sscp/ws22-refresh/extras/ws22-logic-pcba-release-fixture.3mf

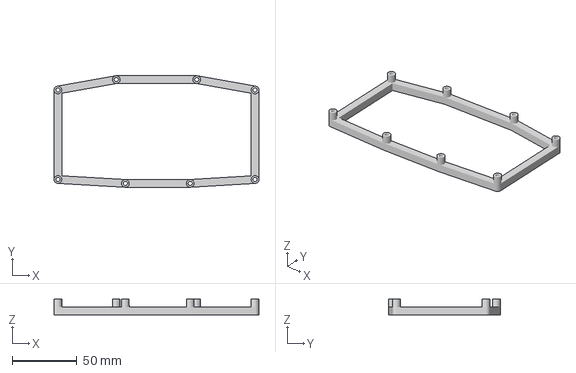
[picture p1: CAD file, 2025-01-11]
extras/ws22-logic-pcba-release-fixture.3mf
158.0 x 86.0 x 12.0 mm
