sscp/ws22-refresh/(list of files, cad)

Other CAD files:
extras/ws22-logic-pcba-release-fixture.f3d
extras/ws22-stock-enclosure.f3d
