sscp/ws22-refresh/pcba/ws22_companion-1_0_0/ws22_companion-1_0_0.pdf

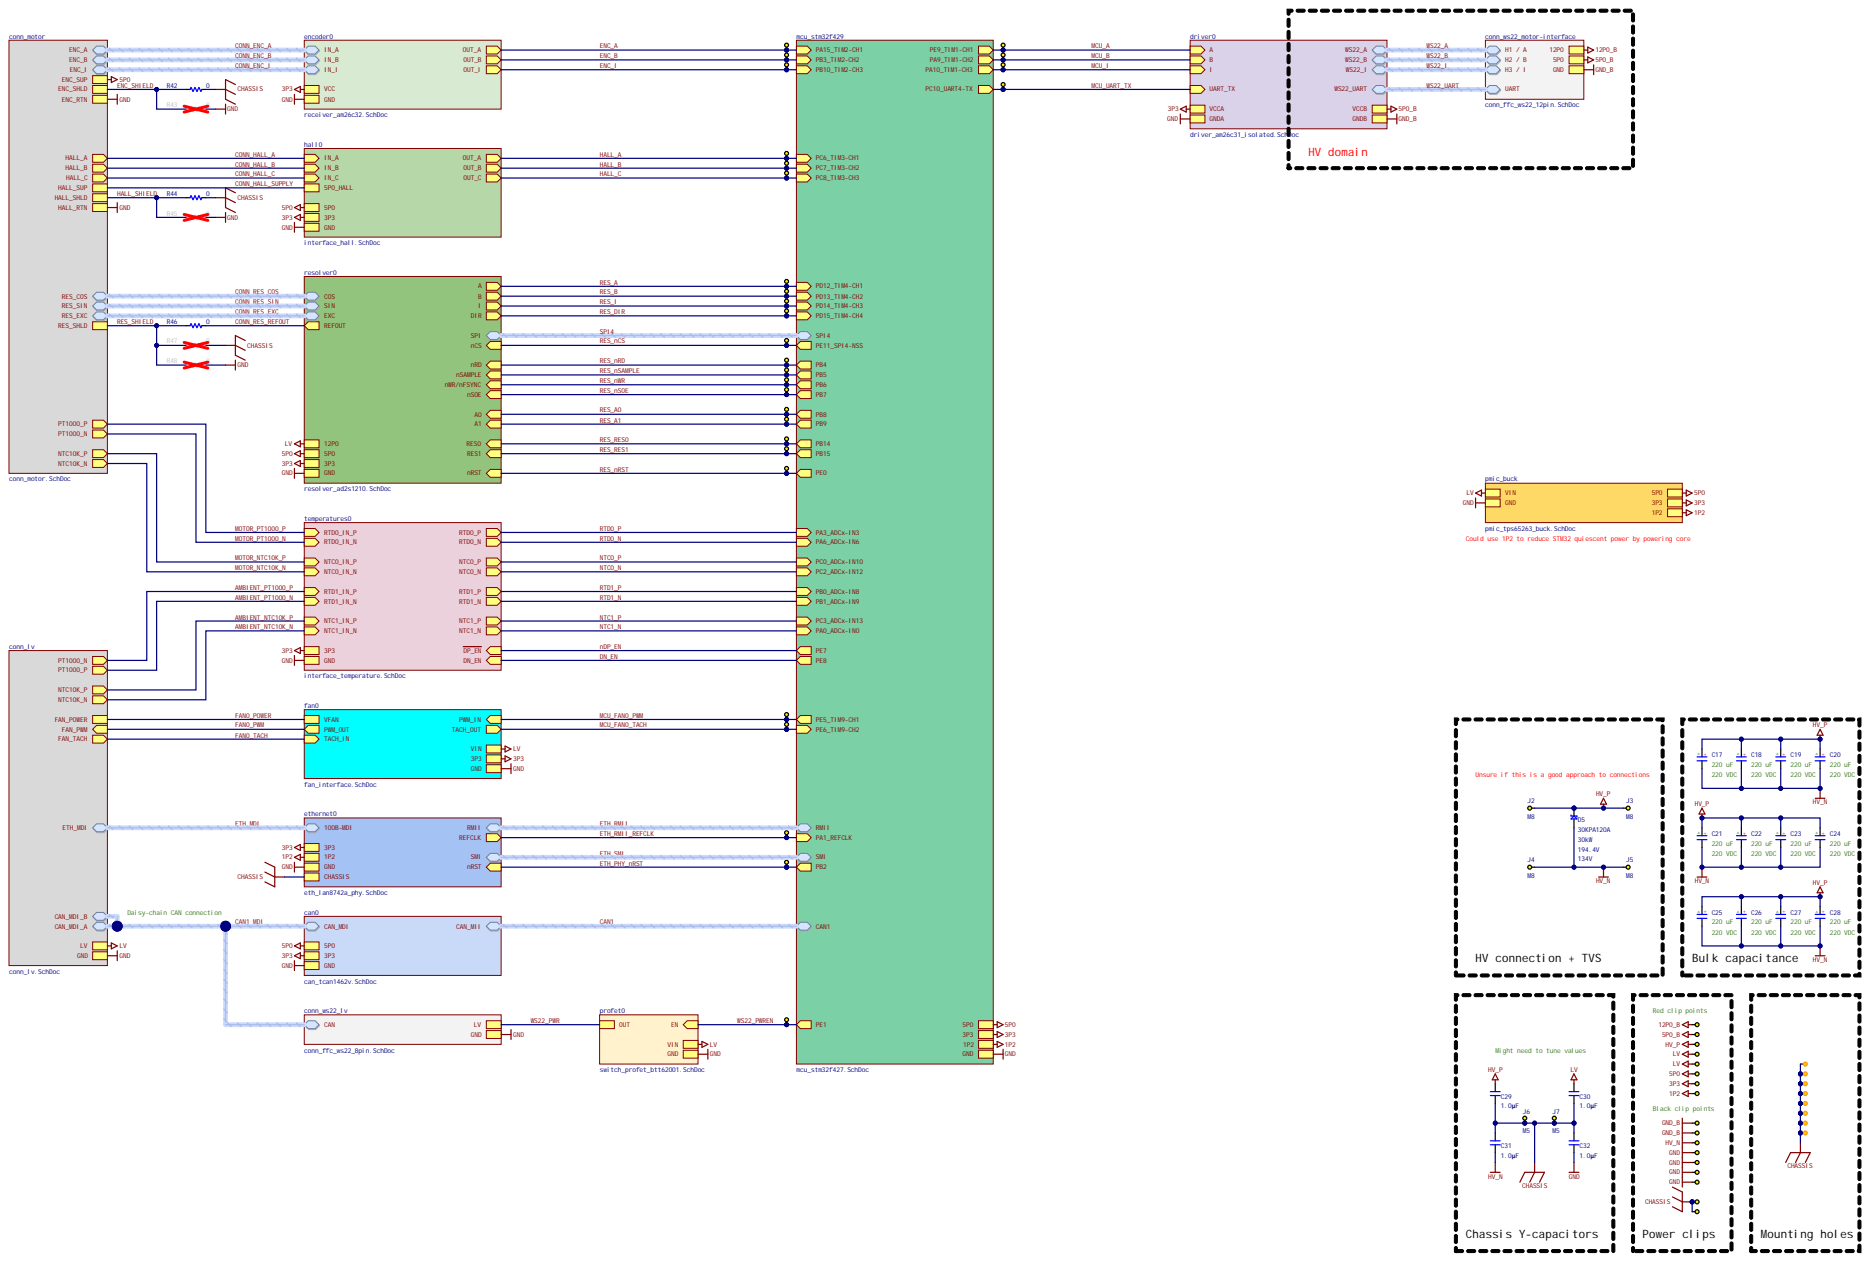
[picture p2: page 1]

CONN_ENC_B | | ENC_B | MCU_B | WS22_B
CONN_ENC_I | | ENC_I | MCU_I | WS22_I

MCU_UART_TX | WS22_UART

CONN_HALL_B | HALL_B
CONN_HALL_C | HALL_C

HALL_SHIELD R44

CONN_RES_SIN | | RES_I
CONN_RES_EXC | | RES_DIR

RES_SHIELD R46 0 CONN_RES_REFOUT | | SPI4

MOTOR_PT1000_N | RTD0_N

Could use 1P2 to reduce STM32 quiescent power by powering core

MOTOR_NTC10K_P | NTC0_P
MOTOR_NTC10K_N | NTC0_N

AMBIENT_PT1000_N | RTD1_N

AMBIENT_NTC10K_P | NTC1_P
AMBIENT_NTC10K_N | NTC1_N

PT1000_N PT1000_P NTC10K_P NTC10K_N FAN_POWER FAN_PWM FAN_TACH ETH_MDI CAN_MDI_B CAN_MDI_A LV GND | | DN_EN

3P3 | nDP_EN

Unsure if this is a good approach to connections

Daisy-chain CAN connection

Might need to tune values

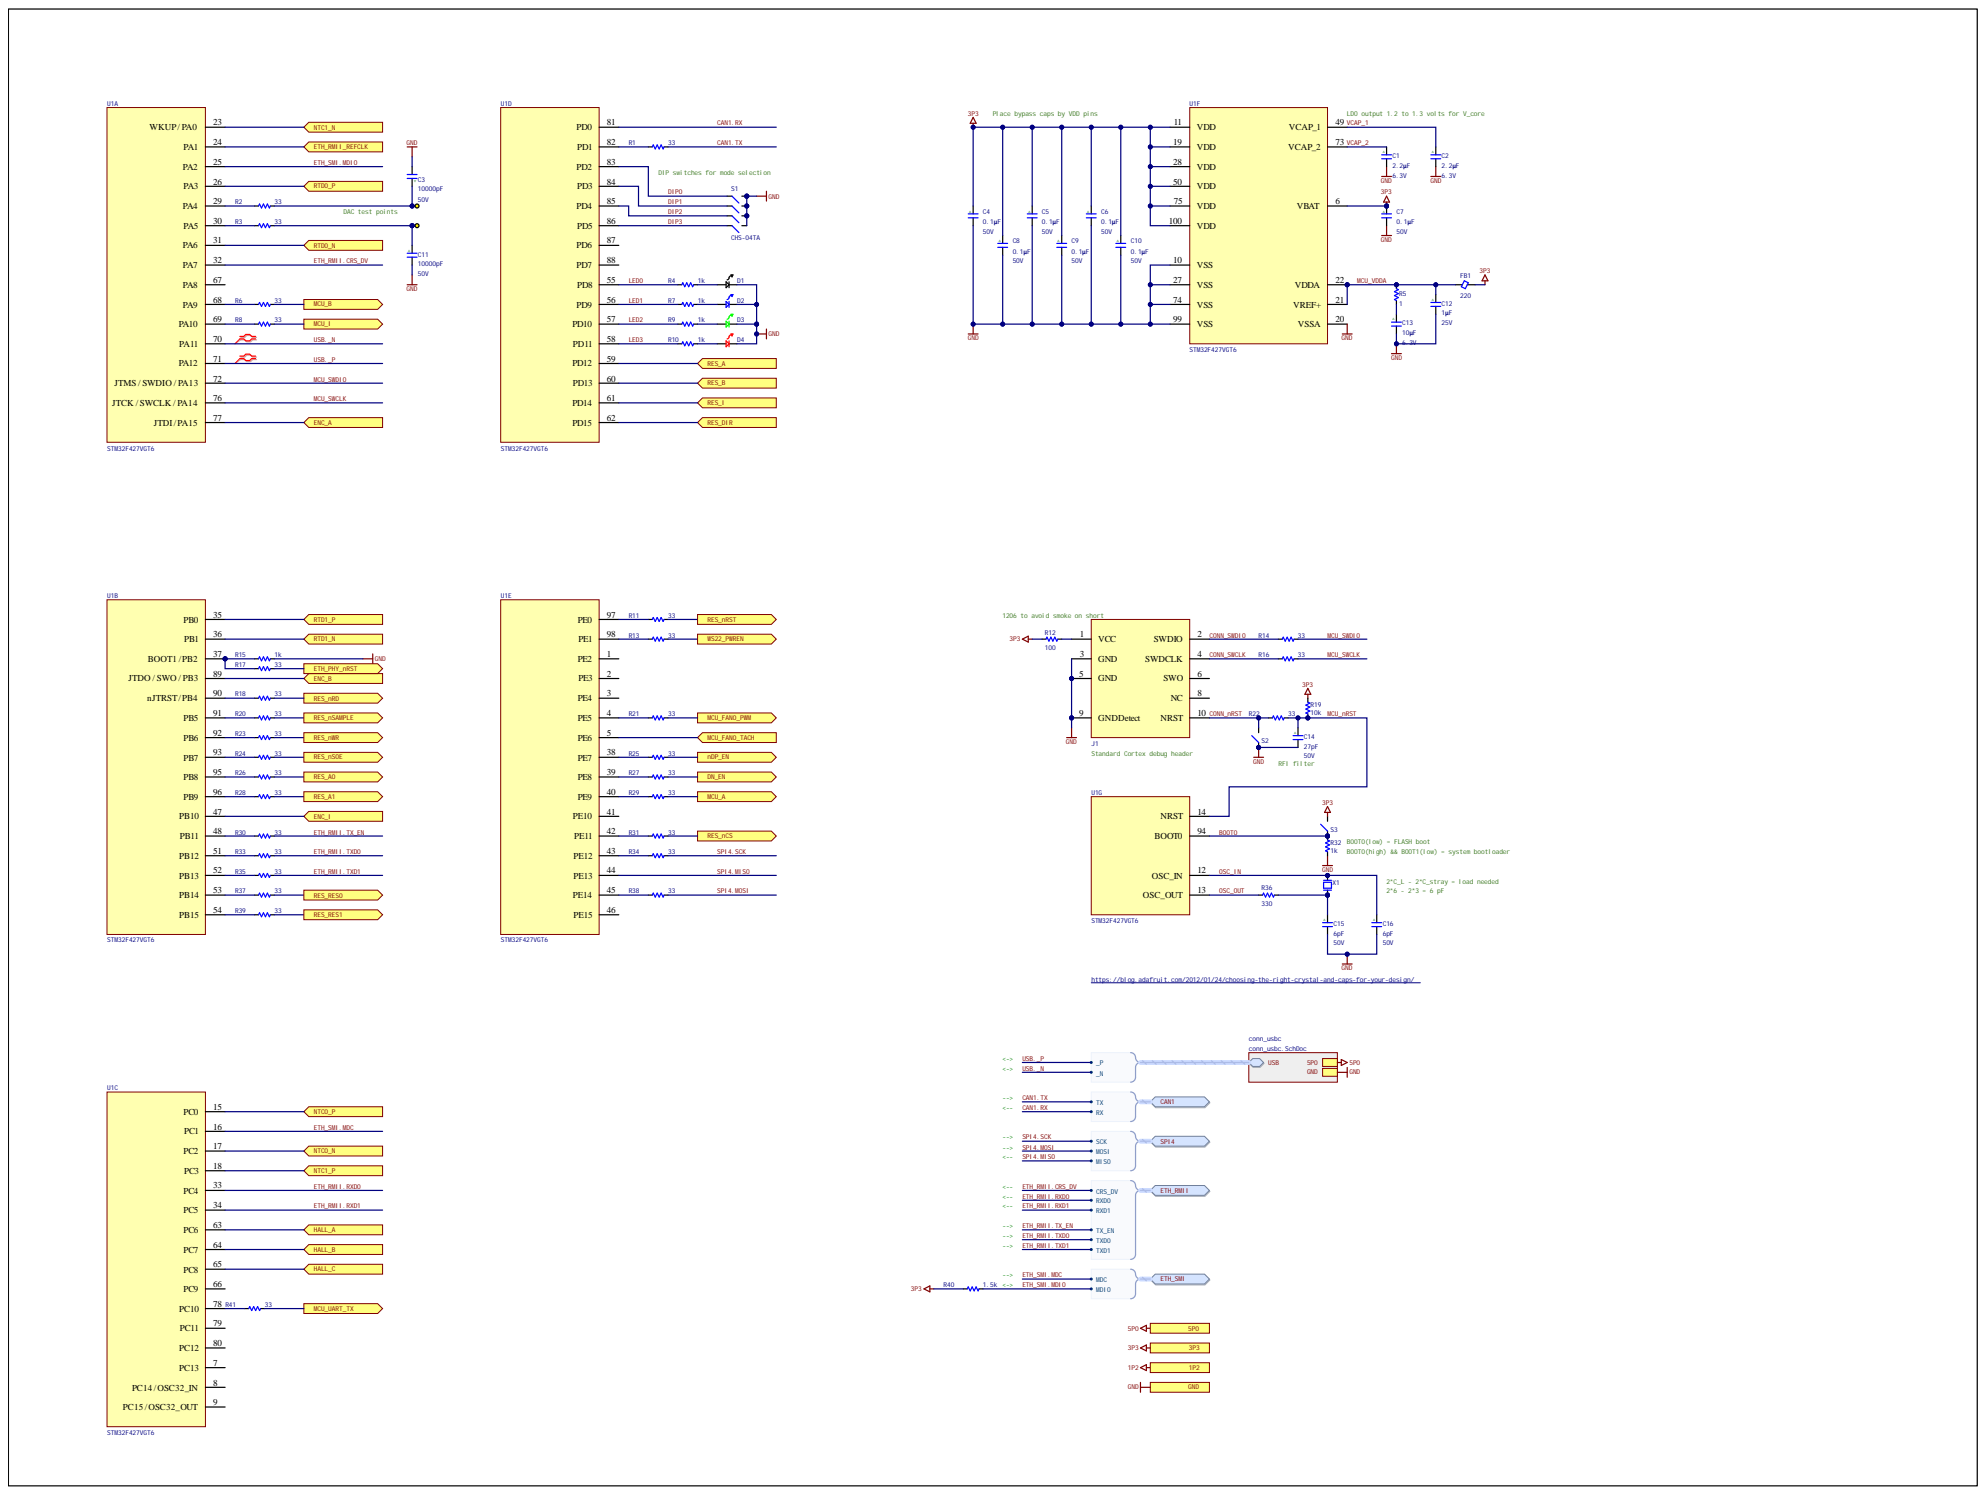
[picture p3: page 2]

Place bypass caps by VDD pins

LDO output 1.2 to 1.3 volts for V_core
VCAP_1

DIP switches for mode selection

1206 to avoid smoke on short

Standard Cortex debug header

https://blog.adafruit.com/2012/01/24/choosing-the-right-crystal-and-caps-for-your-design/

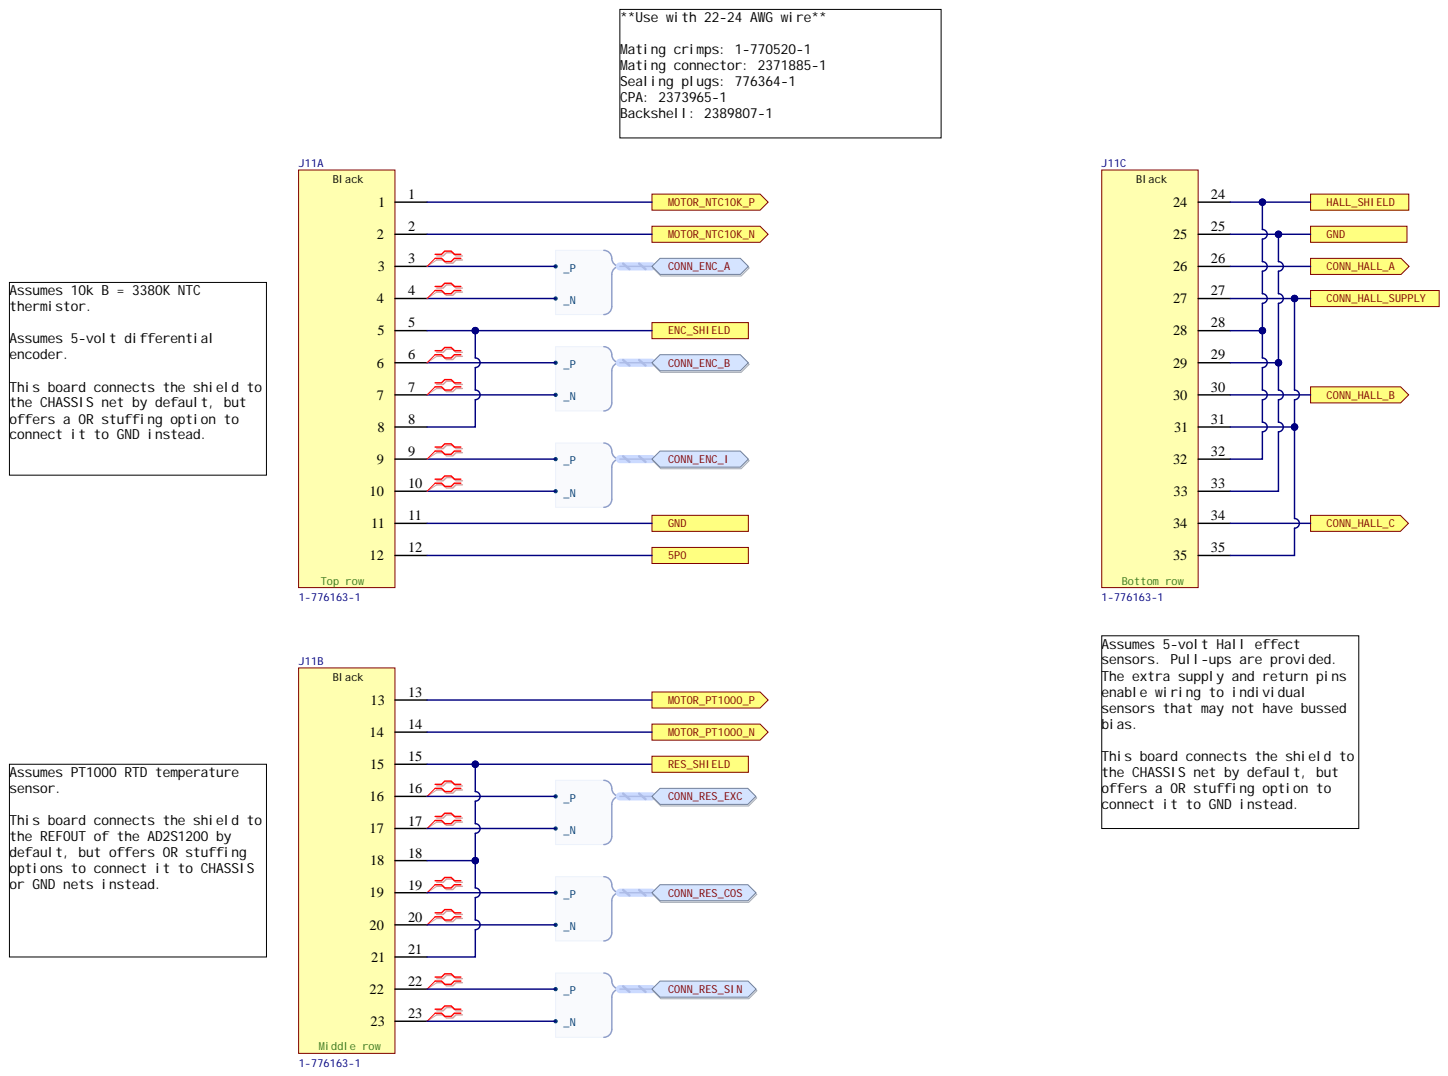
[picture p4: page 3]

**Use with 22-24 AWG wire**

This board connects the shield to
the CHASSIS net by default, but
offers a 0R stuffing option to
connect it to GND instead.

Assumes 5-volt Hall effect
sensors. Pull-ups are provided.
The extra supply and return pins
enable wiring to individual
sensors that may not have bussed
bias.

the REFOUT of the AD2S1200 by
default, but offers 0R stuffing
options to connect it to CHASSIS
or GND nets instead.

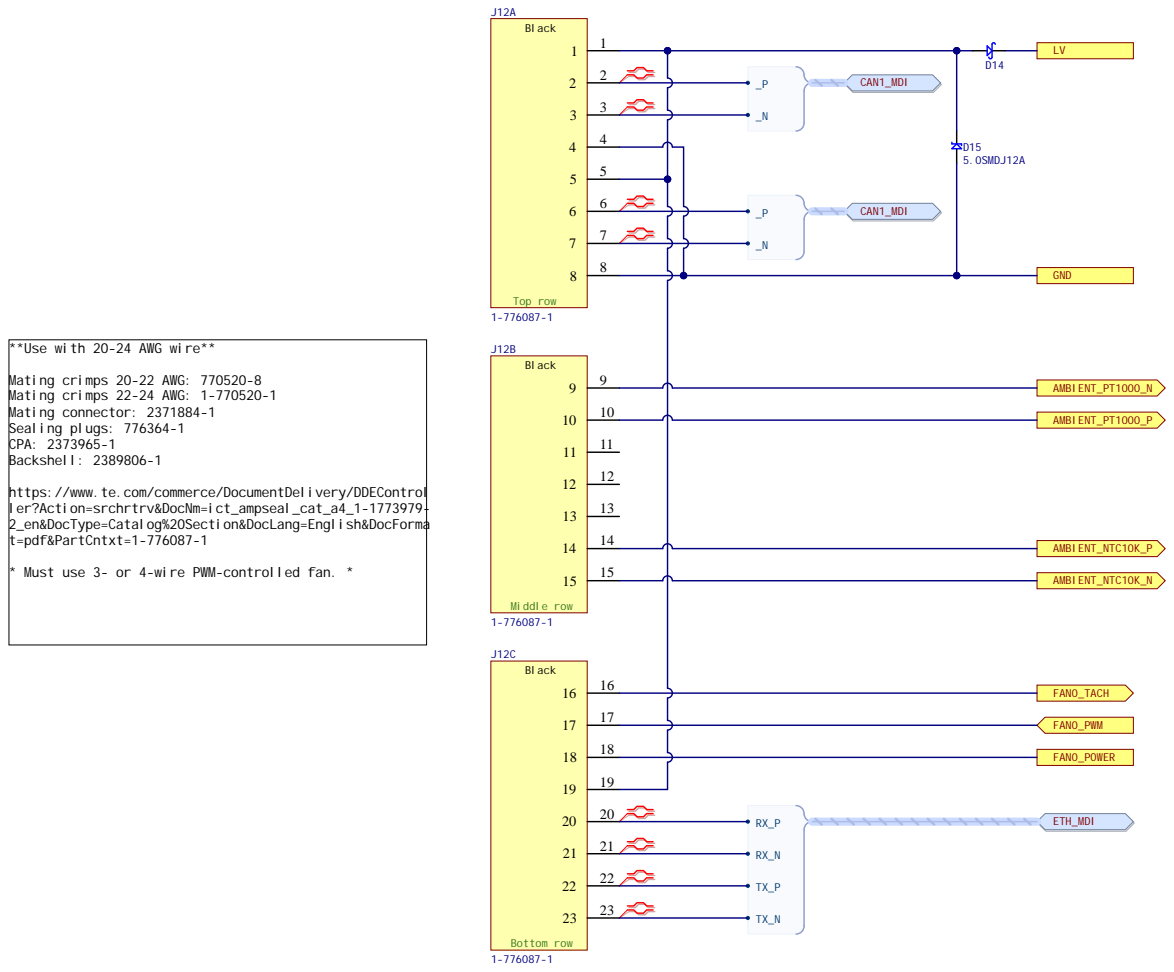
[picture p5: page 4]

**Use with 20-24 AWG wire**

https://www.te.com/commerce/DocumentDelivery/DDEControl
ler?Action=srchrtrv&DocNm=ict_ampseal_cat_a4_1-1773979-
2_en&DocType=Catalog%20Section&DocLang=English&DocForma
t=pdf&PartCntxt=1-776087-1

* Must use 3- or 4-wire PWM-controlled fan. *

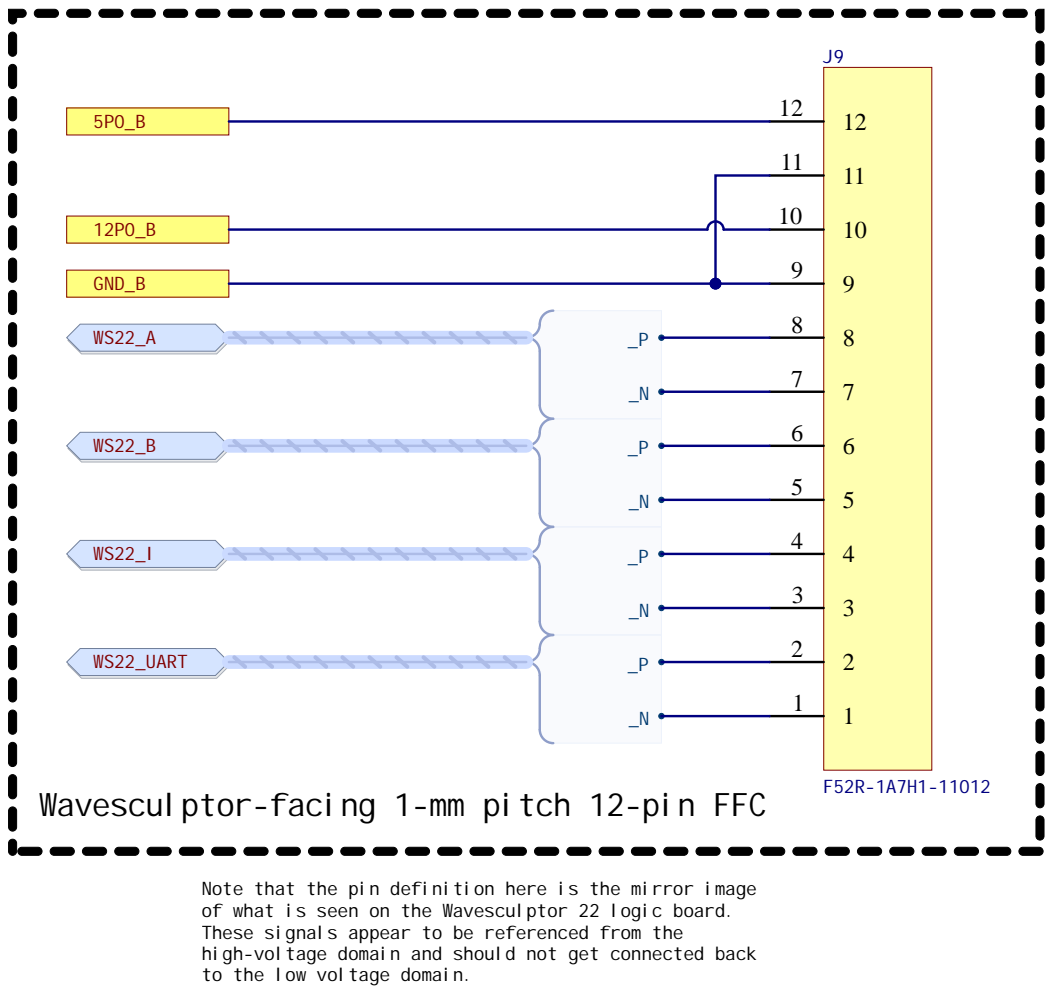
[picture p6: page 5]

Wavesculptor-facing 1-mm pitch 12-pin FFC

Note that the pin definition here is the mirror image
of what is seen on the Wavesculptor 22 logic board.
These signals appear to be referenced from the
high-voltage domain and should not get connected back
to the low voltage domain.

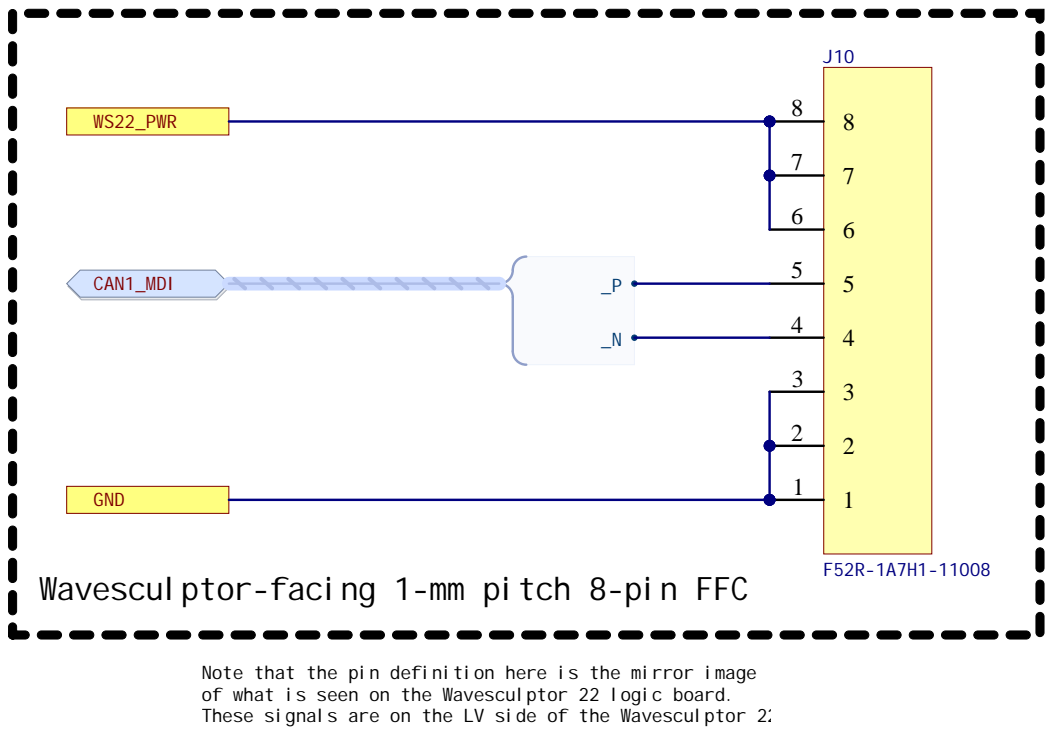
[picture p7: page 6]

Wavesculptor-facing 1-mm pitch 8-pin FFC

Note that the pin definition here is the mirror image
of what is seen on the Wavesculptor 22 logic board.
These signals are on the LV side of the Wavesculptor 22

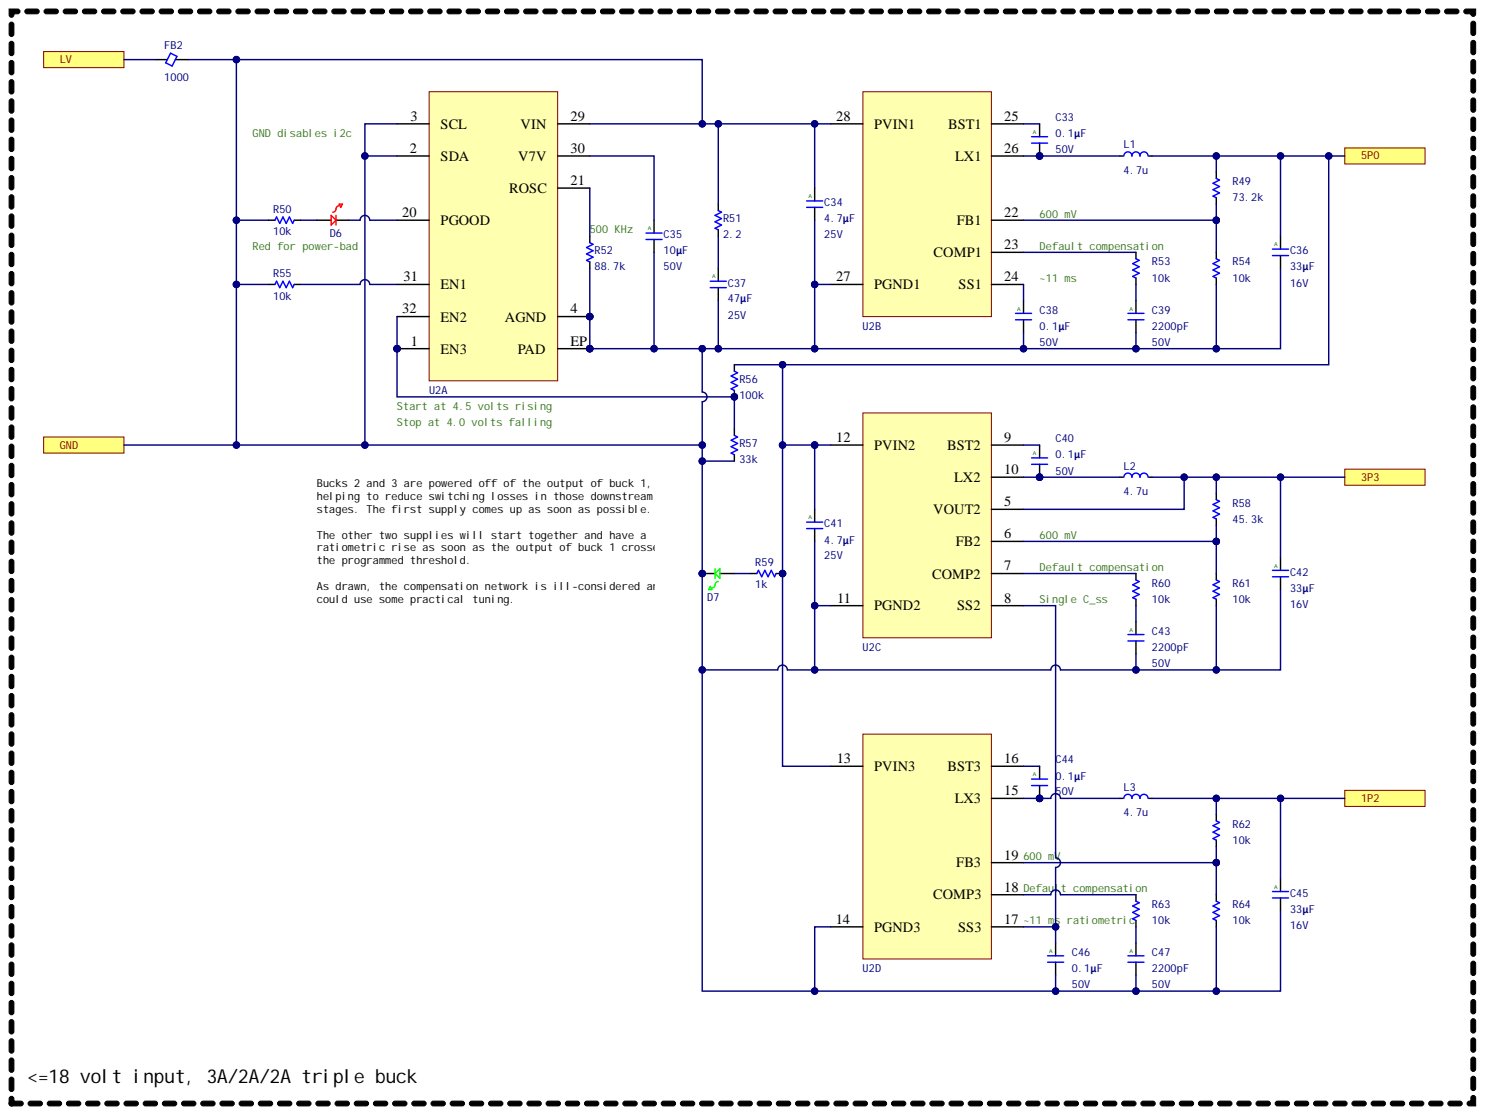
[picture p8: page 7]

G N D | i 2 c 1 0 k | | 2 | VIN S D A RO S D 20 P G O O 1 31 E N A G N D | 29 V7V 30

C 3 4 | PVIN1 28 U2B 1 27 CO M P P G N D S S

1 | | E P
E N 3 PA D

<=18 volt input, 3A/2A/2A triple buck

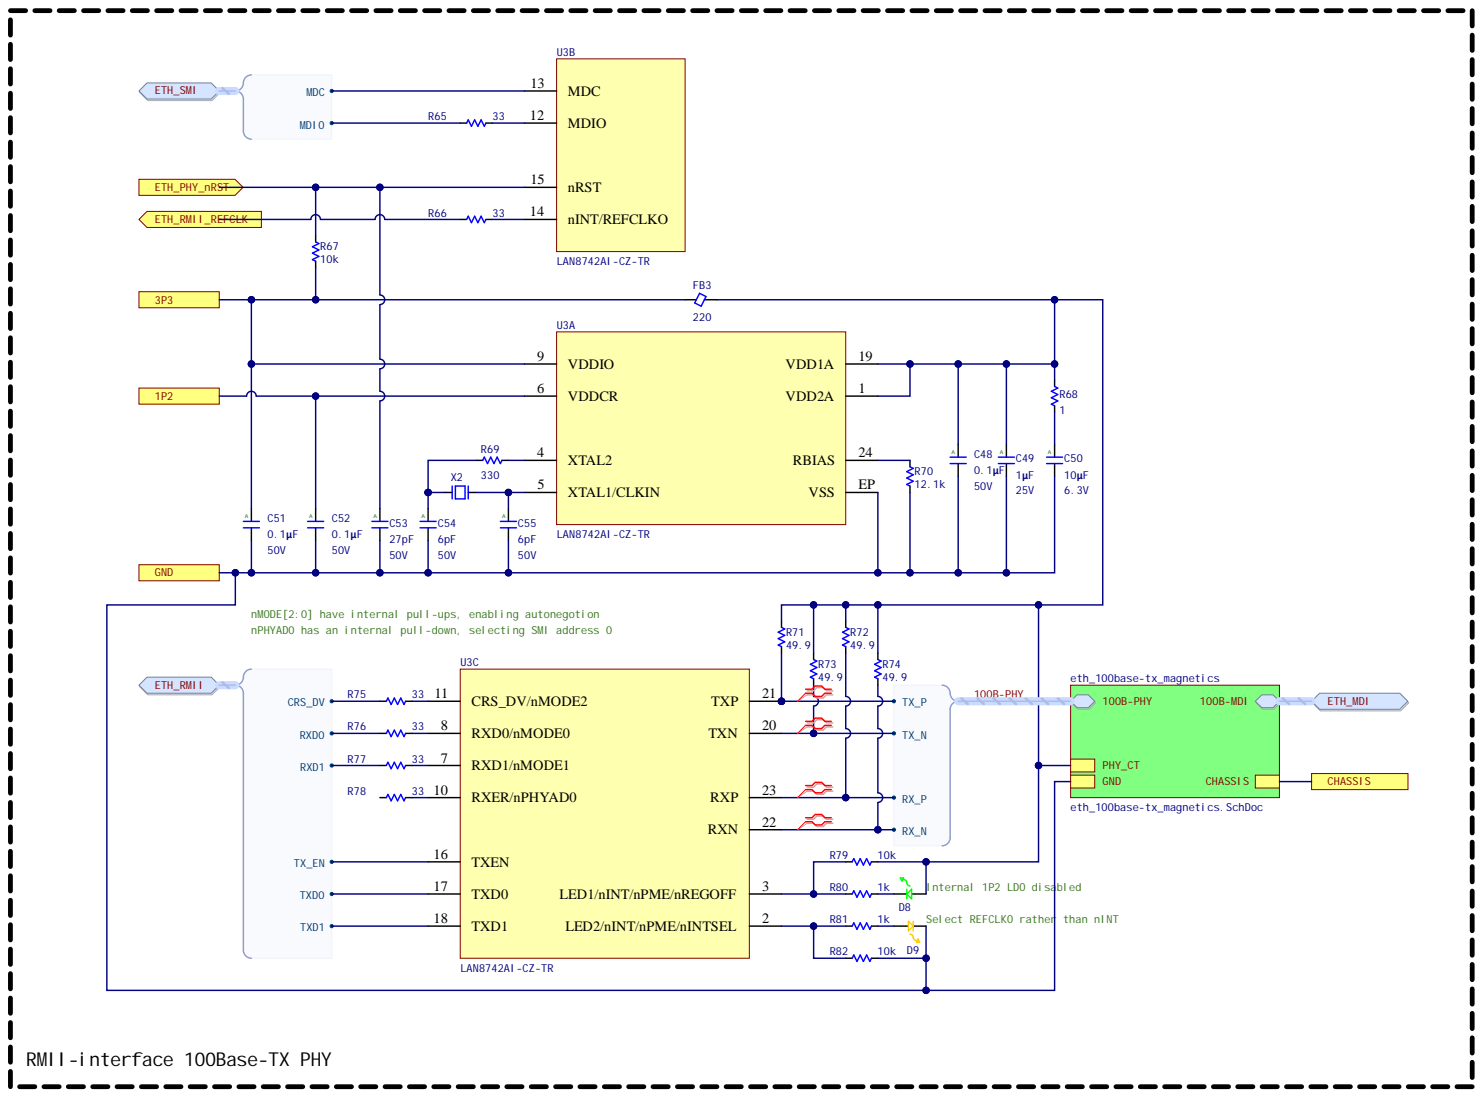
[picture p9: page 8]

nMODE[2:0] have internal pull-ups, enabling autonegotion
nPHYAD0 has an internal pull-down, selecting SMI address 0

Internal 1P2 LDO disabled
Select REFCLKO rather than nINT

RMII-interface 100Base-TX PHY

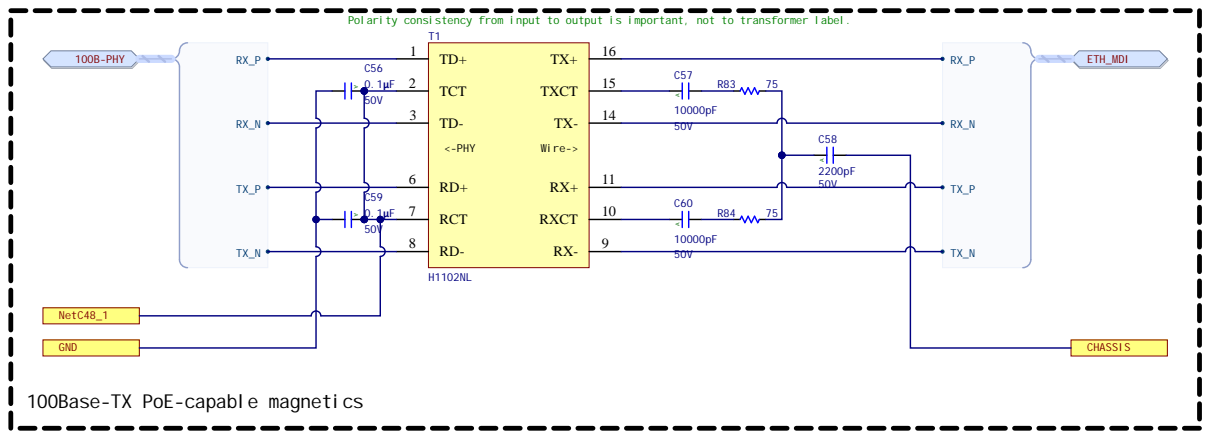
[picture p10: page 9]

Polarity consistency from input to output is important, not to transformer label.

100Base-TX PoE-capable magnetics

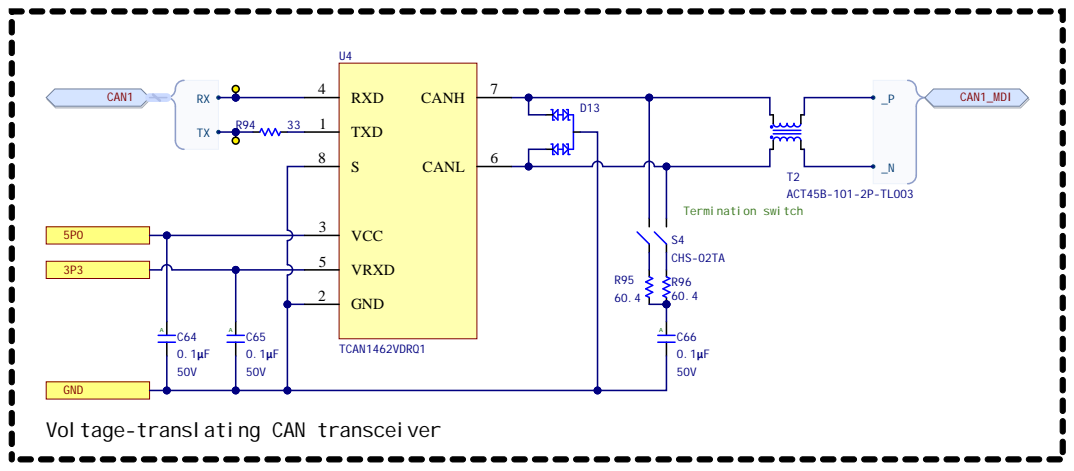
[picture p11: page 10]

VCC 3

VRXD 5

GND 2

GND
Voltage-translating CAN transceiver

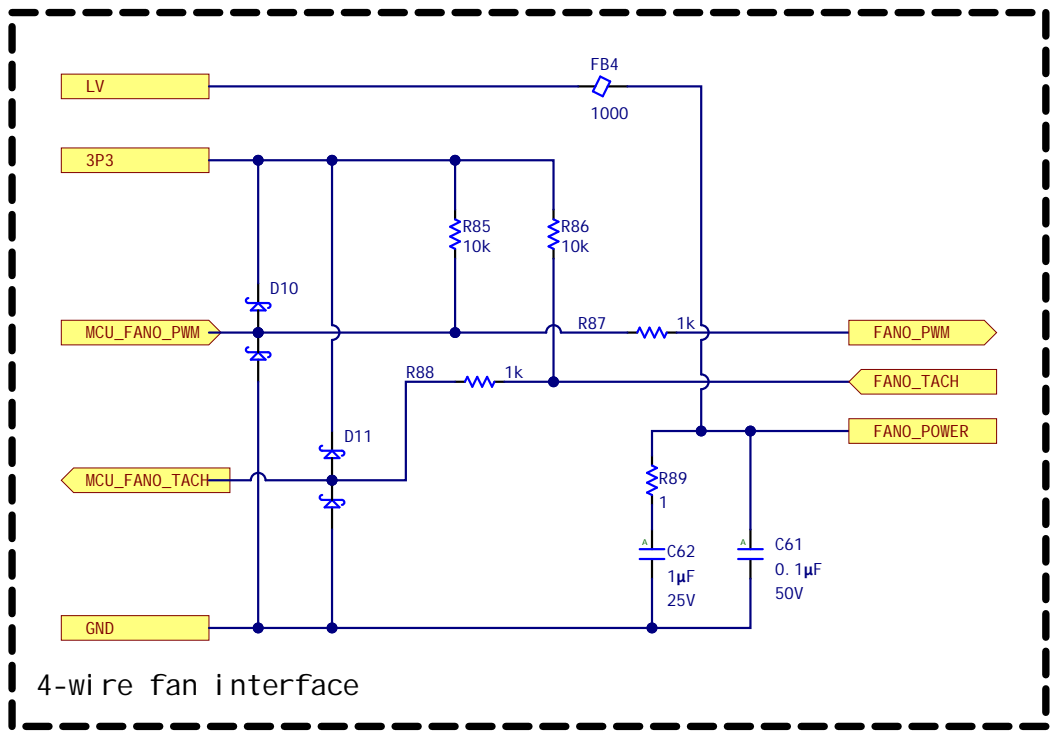
[picture p12: page 11]

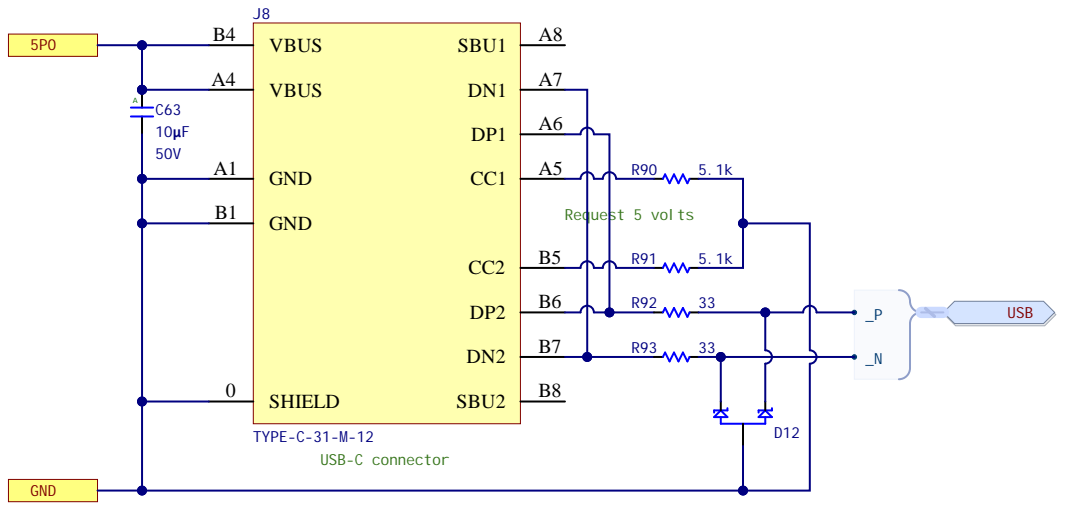
[picture p13: page 12]

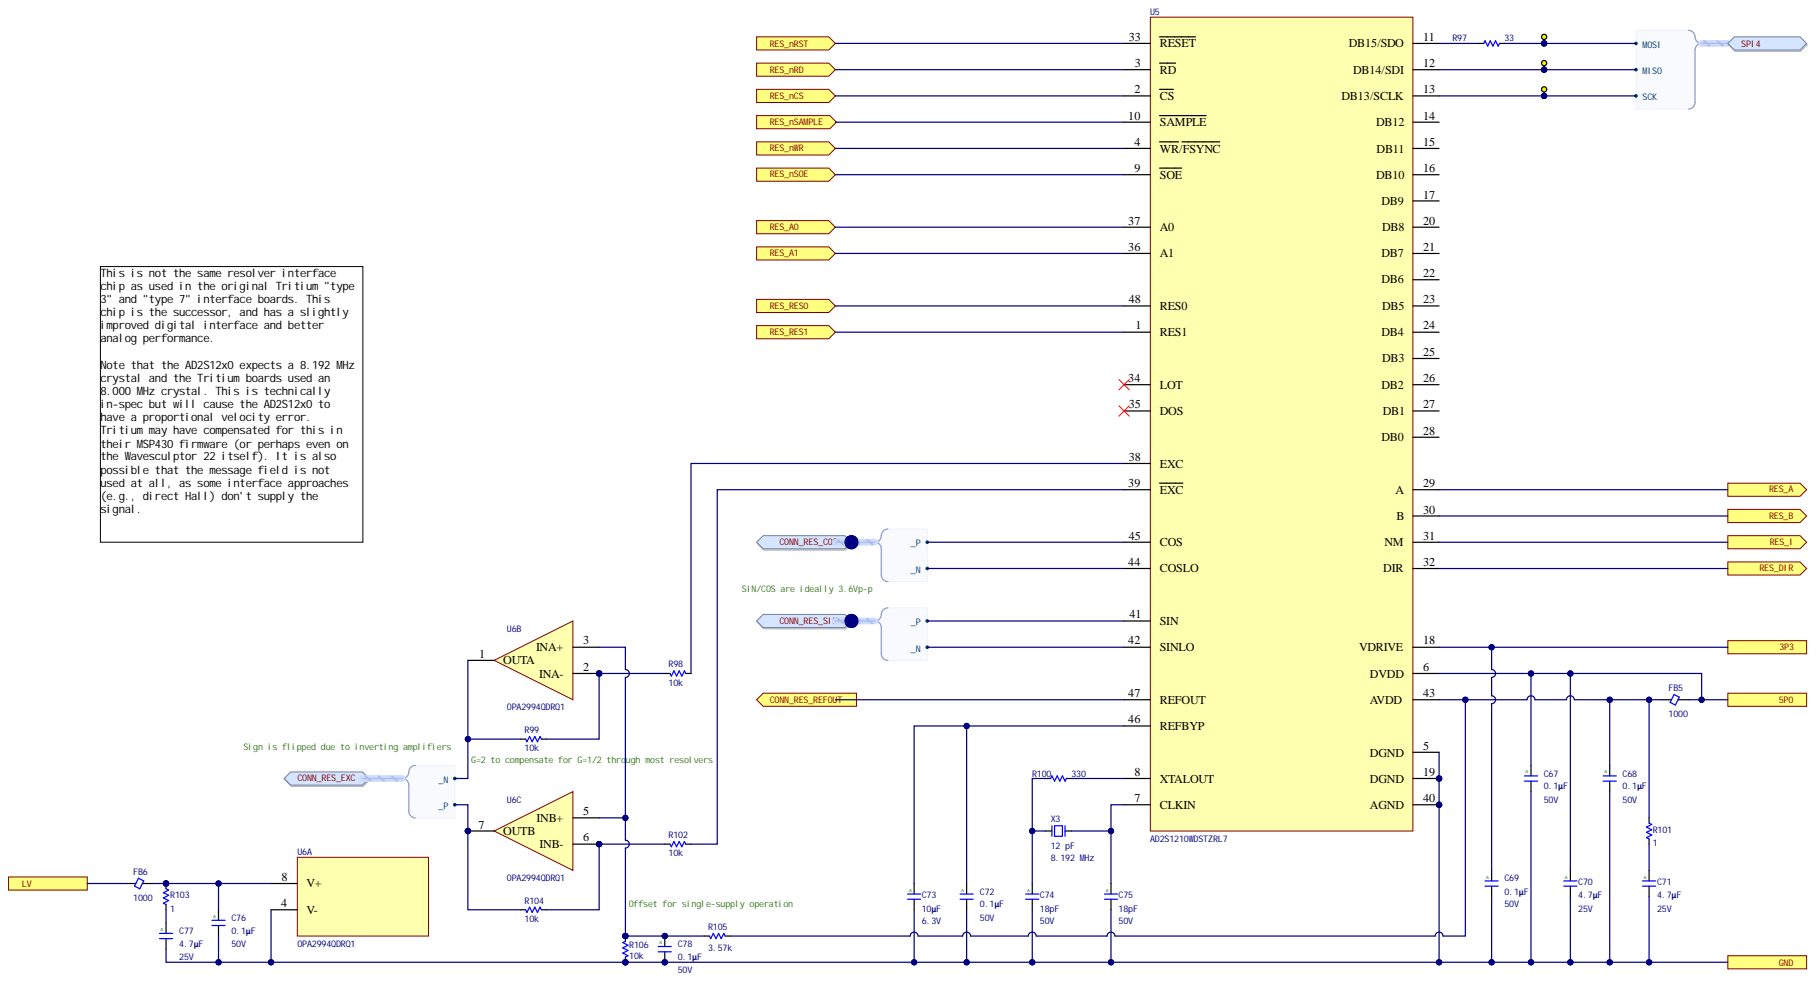
[picture p14: page 13]

This is not the same resolver interface
chip as used in the original Tritium "type
3" and "type 7" interface boards. This
chip is the successor, and has a slightly
improved digital interface and better
analog performance.

Note that the AD2S12x0 expects a 8.192 MHz
crystal and the Tritium boards used an
8.000 MHz crystal. This is technically
in-spec but will cause the AD2S12x0 to
have a proportional velocity error.
Tritium may have compensated for this in
their MSP430 firmware (or perhaps even on
the Wavesculptor 22 itself). It is also
possible that the message field is not
used at all, as some interface approaches
(e.g., direct Hall) don't supply the
signal.

EXC 39

CONN_RES_COS _P SIN/COS are ideally 3.6Vp-p CONN_RES_SIN _P | COS 45 COSLO 44 SIN 41 SINLO 42 REFOUT 47 REFBYP 46

CONN_RES_REFOUT | | | FB5

Sign is flipped due to inverting amplifiers

G=2 to compensate for G=1/2 through most resolvers

R100 330 | XTALOUT 8

A | | 12 pF 8.192 MHz

Offset for single-supply operation

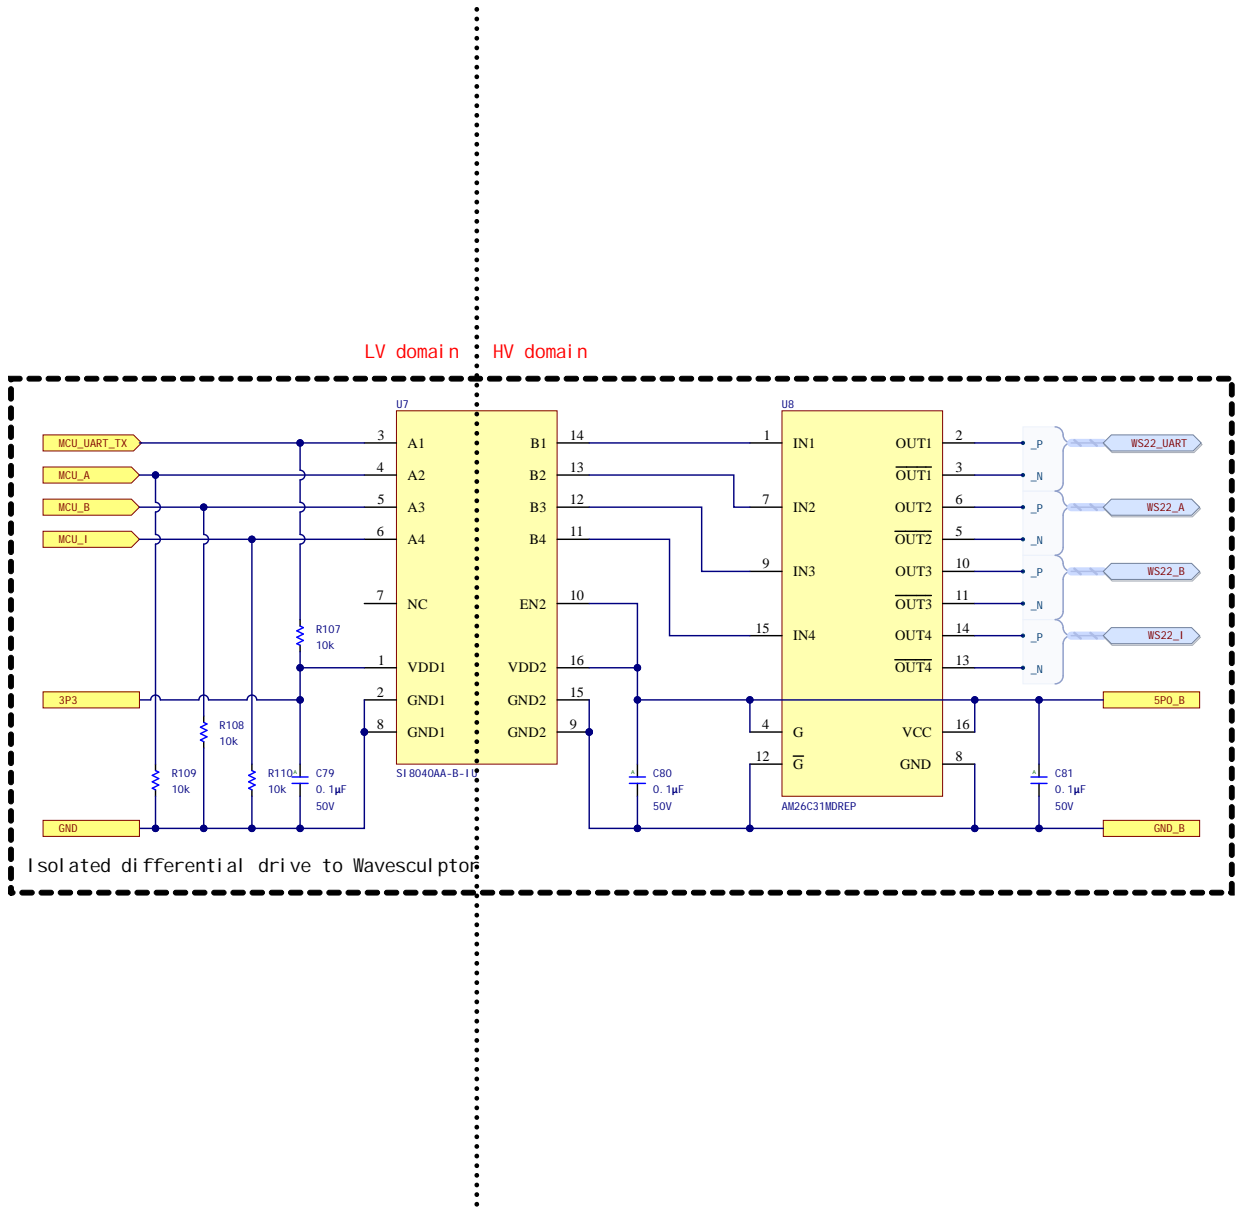
[picture p15: page 14]

GND
Isolated differential drive to Wavesculptor

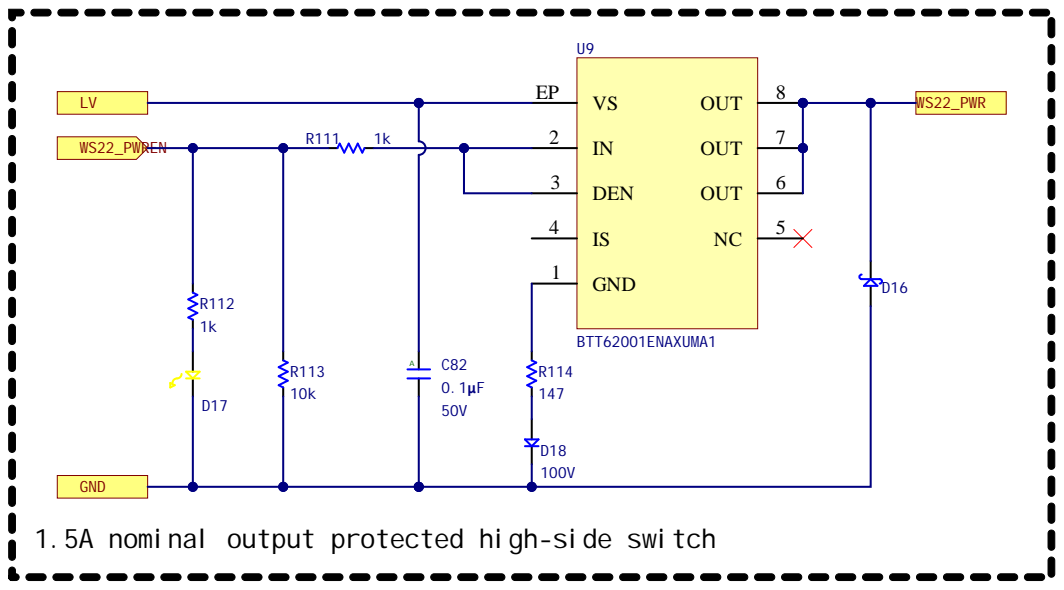
[picture p16: page 15]

GND
1.5A nominal output protected high-side switch

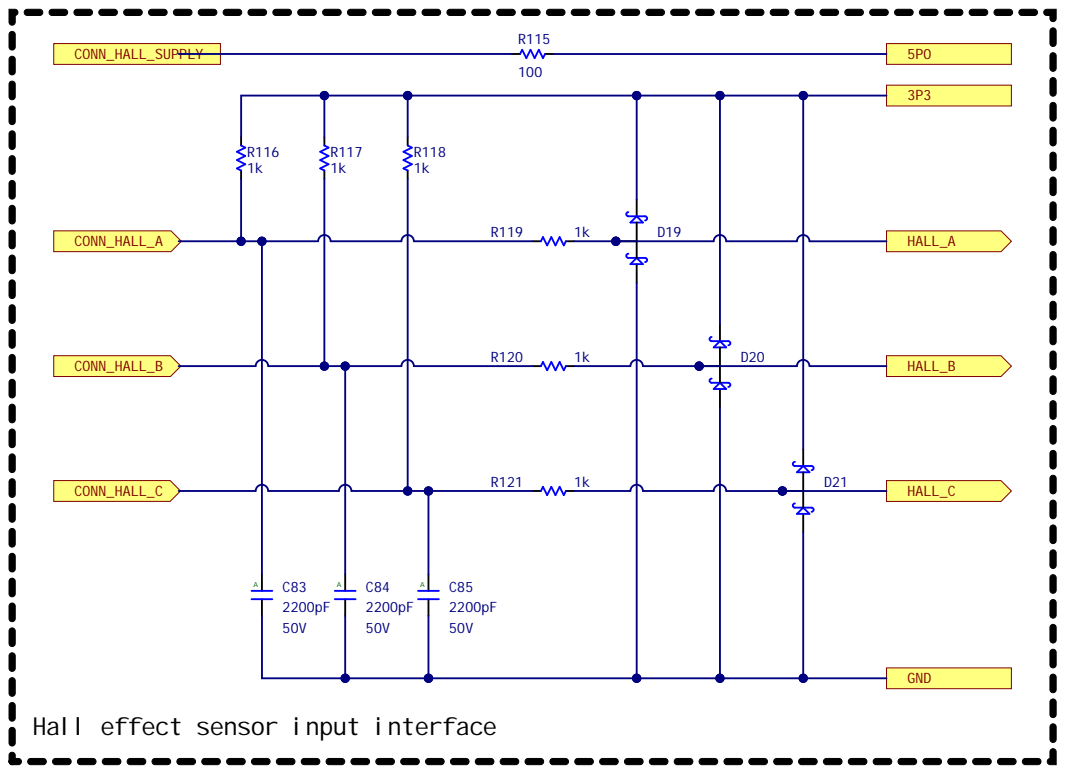
[picture p17: page 16]

Hall effect sensor input interface

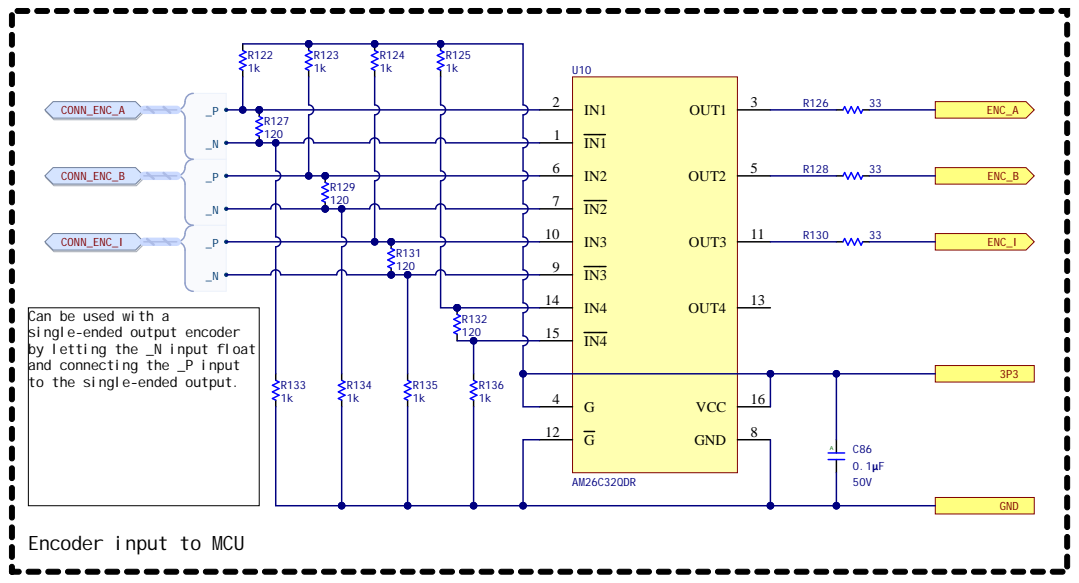
[picture p18: page 17]

Can be used with a
single-ended output encoder
by letting the _N input float
and connecting the _P input
to the single-ended output.

Encoder input to MCU

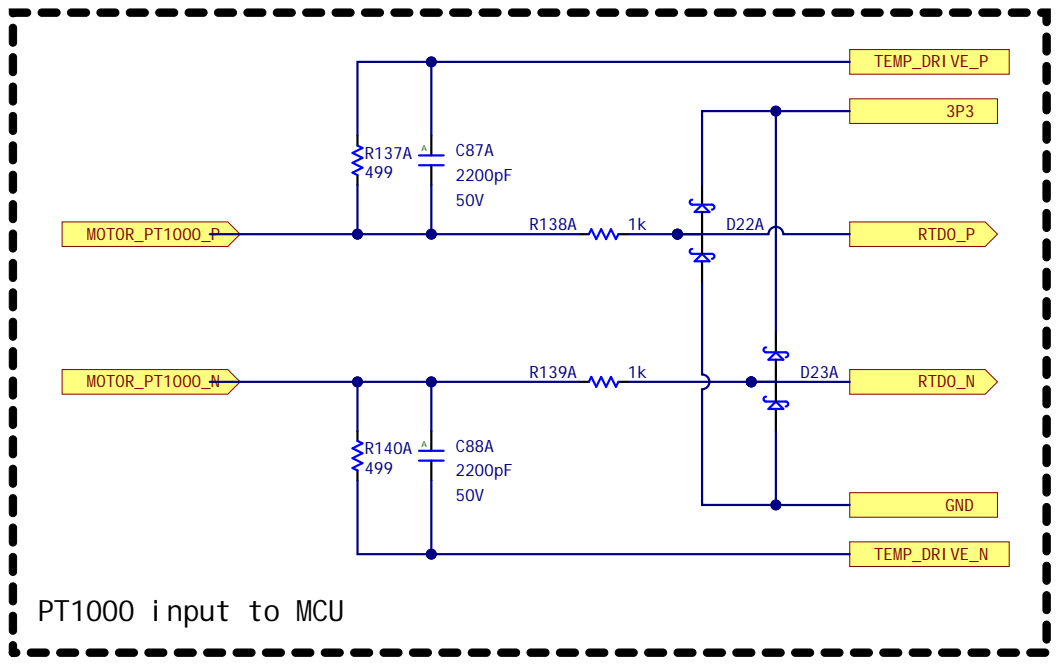
[picture p19: page 18]

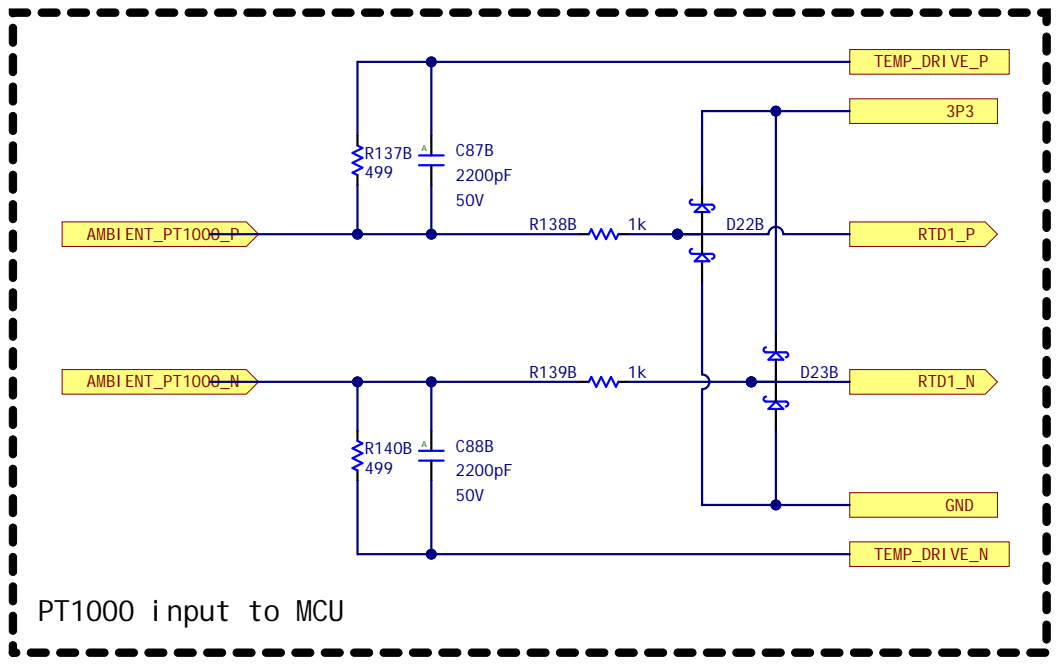
[picture p20: page 19]

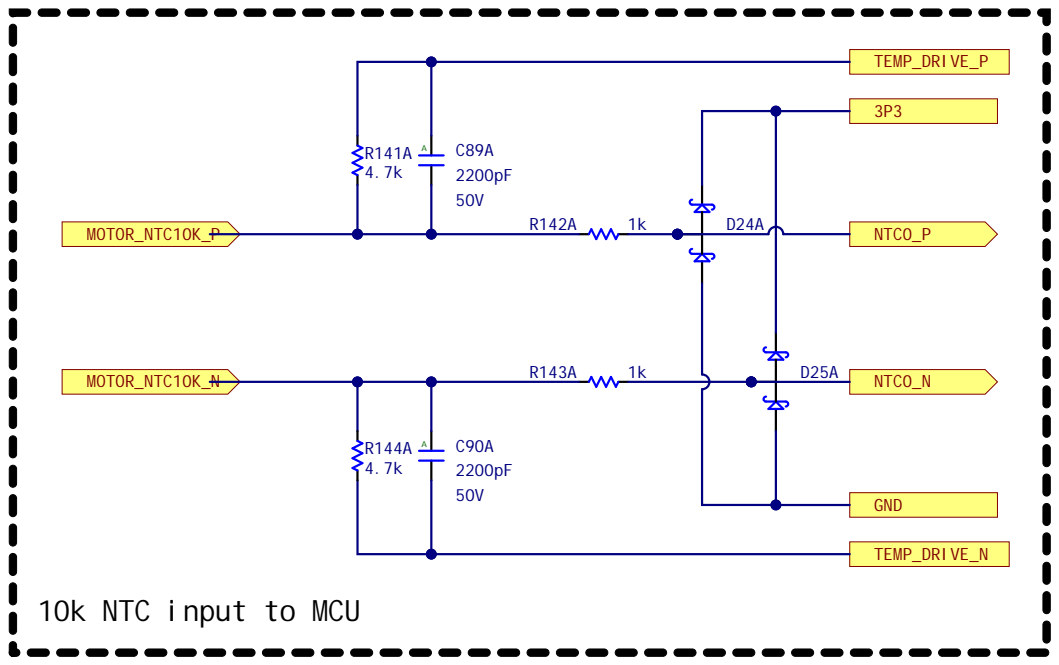
[picture p21: page 20]

10k NTC input to MCU

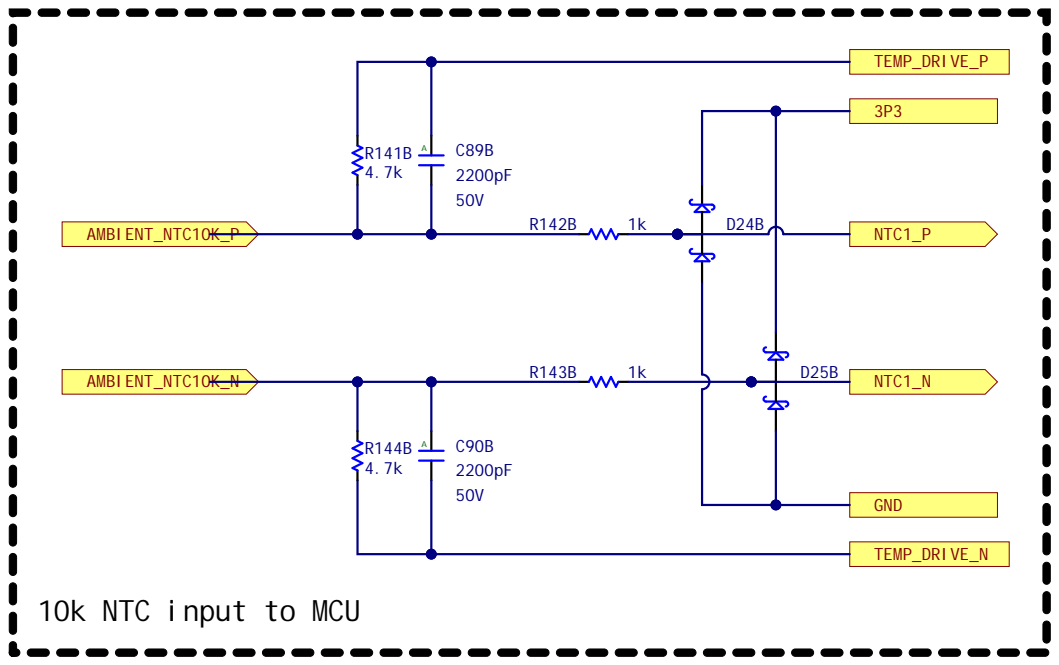
[picture p22: page 21]

10k NTC input to MCU

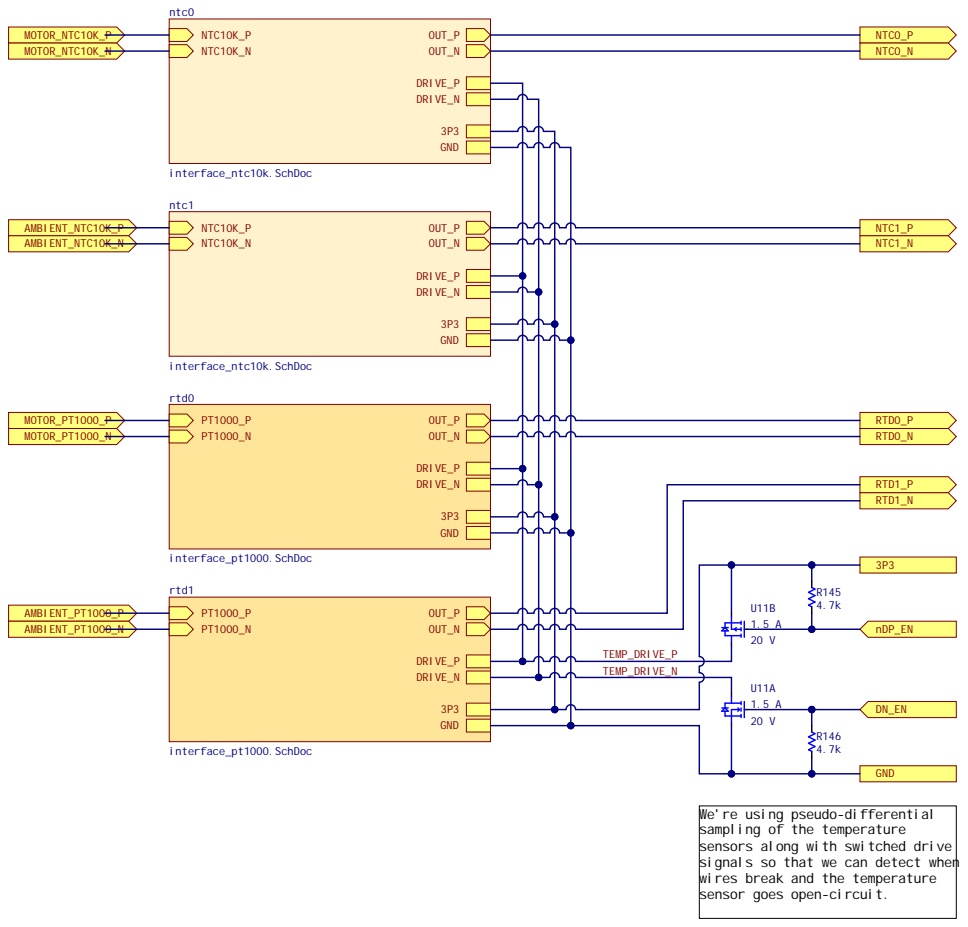
[picture p23: page 22]

We're using pseudo-differential
sampling of the temperature
sensors along with switched drive
signals so that we can detect when
wires break and the temperature
sensor goes open-circuit.
