sscp/ws22-refresh/pcba/simulations/excitation_amplifier.asc

R1: res; 10k
R2: res; 3.57k
R3: res; 10k
R4: res; 10k
R5: res; 10k
R6: res; 10k
R7: res; 120
U1: UniversalOpAmp2; Avol=1Meg GBW=24Meg Slew=35Meg; Ilimit=125m Rail=0 Vos=0
U2: UniversalOpAmp2; Avol=1Meg GBW=24Meg Slew=35Meg; Ilimit=125m Rail=0 Vos=0
V1: voltage; 12
V2: voltage; 5
V3: voltage; SINE(2.47 1.8 20k)
V4: voltage; SINE(2.47 1.8 20k 0 0 180)
Named nets: 0, OUT, IN, nOUT, REF, nIN
.tran 0 1m 0 1n uic
