sscp/ws22-refresh/(list of files, drawings)

Other design files:
pcba/ws22_companion-1_0_0/can_tcan1462v.SchDoc
pcba/ws22_companion-1_0_0/conn_ffc_ws22_8pin.SchDoc
pcba/ws22_companion-1_0_0/conn_ffc_ws22_12pin.SchDoc
pcba/ws22_companion-1_0_0/conn_lv.SchDoc
pcba/ws22_companion-1_0_0/conn_motor.SchDoc
pcba/ws22_companion-1_0_0/conn_usbc.SchDoc
pcba/ws22_companion-1_0_0/driver_am26c31_isolated.SchDoc
pcba/ws22_companion-1_0_0/eth_100base-tx_magnetics.SchDoc
pcba/ws22_companion-1_0_0/eth_lan8742a_phy.SchDoc
pcba/ws22_companion-1_0_0/fan_interface.SchDoc
pcba/ws22_companion-1_0_0/interface_hall.SchDoc
pcba/ws22_companion-1_0_0/interface_ntc10k.SchDoc
pcba/ws22_companion-1_0_0/interface_pt1000.SchDoc
pcba/ws22_companion-1_0_0/interface_temperature.SchDoc
pcba/ws22_companion-1_0_0/mcu_stm32f427.SchDoc
pcba/ws22_companion-1_0_0/pmic_tps65263_buck.SchDoc
pcba/ws22_companion-1_0_0/receiver_am26c32.SchDoc
pcba/ws22_companion-1_0_0/resolver_ad2s1210.SchDoc
pcba/ws22_companion-1_0_0/switch_profet_btt62001.SchDoc
pcba/ws22_companion-1_0_0/top.SchDoc
pcba/ws22_companion-1_0_0/ws22_companion-1_0_0.PrjPcb
