sscp/ws22-refresh/pcba/ws22_companion-1_0_0/ws22_companion-1_0_0.ioc

Mcu.UserName=STM32F427VGTx
PA0/WKUP.GPIO_Label=NTC1_N
PA0/WKUP.Signal=ADCx_IN0
PA1.Signal=ETH_REF_CLK
PA10.GPIO_Label=WS22_I
PA10.Signal=S_TIM1_CH3
PA11.Signal=USB_OTG_FS_DM
PA12.Signal=USB_OTG_FS_DP
PA13.Signal=SYS_JTMS-SWDIO
PA14.Signal=SYS_JTCK-SWCLK
PA15.GPIO_Label=ENC_A
PA15.Signal=S_TIM2_CH1_ETR
PA2.Signal=ETH_MDIO
PA3.GPIO_Label=RTD0_P
PA3.Signal=ADCx_IN3
PA4.Signal=COMP_DAC1_group
PA5.Signal=COMP_DAC2_group
PA6.GPIO_Label=RTD0_N
PA6.Signal=ADCx_IN6
PA7.Signal=ETH_CRS_DV
PA9.GPIO_Label=WS22_B
PA9.Signal=S_TIM1_CH2
PB0.GPIO_Label=RTD1_P
PB0.Signal=ADCx_IN8
PB1.GPIO_Label=RTD1_N
PB1.Signal=ADCx_IN9
PB10.GPIO_Label=ENC_I
PB10.Signal=S_TIM2_CH3
PB11.Signal=ETH_TX_EN
PB12.Signal=ETH_TXD0
PB13.Signal=ETH_TXD1
PB2/BOOT1.GPIO_Label=ETH_nRST
PB2/BOOT1.Signal=GPIO_Output
PB3.GPIO_Label=ENC_B
PB3.Signal=S_TIM2_CH2
PB4.GPIO_Label=RES_nRD
PB4.Signal=GPIO_Output
PB5.Signal=CAN2_RX
PB6.Signal=CAN2_TX
PB7.GPIO_Label=RES_nSOE
PB7.Signal=GPIO_Output
PB8.GPIO_Label=RES_A0
PB8.Signal=GPIO_Output
PB9.GPIO_Label=RES_A1
PB9.Signal=GPIO_Output
PC0.GPIO_Label=NTC0_P
PC0.Signal=ADCx_IN10
PC1.Signal=ETH_MDC
PC10.Signal=UART4_TX
PC2.GPIO_Label=NTC0_N
PC2.Signal=ADCx_IN12
PC3.GPIO_Label=NTC1_P
PC3.Signal=ADCx_IN13
PC4.Signal=ETH_RXD0
PC5.Signal=ETH_RXD1
PC6.GPIO_Label=HALL_A
PC6.Signal=S_TIM3_CH1
PC7.GPIO_Label=HALL_B
PC7.Signal=S_TIM3_CH2
PC8.GPIO_Label=HALL_C
PC8.Signal=S_TIM3_CH3
PD12.GPIO_Label=RES_A
PD12.Signal=S_TIM4_CH1
PD13.GPIO_Label=RES_B
PD13.Signal=S_TIM4_CH2
PD14.GPIO_Label=RES_I
PD14.Signal=S_TIM4_CH3
PD15.GPIO_Label=RES_DIR
PD15.Signal=S_TIM4_CH4
PD2.GPIO_Label=DIP0
PD2.Signal=GPIO_Input
PD3.GPIO_Label=DIP1
PD3.Signal=GPIO_Input
PD4.GPIO_Label=DIP2
PD4.Signal=GPIO_Input
PD5.GPIO_Label=DIP3
PD5.Signal=GPIO_Input
PE0.GPIO_Label=RES_nRST
PE0.Signal=GPIO_Output
PE1.GPIO_Label=WS22_PWREN
PE1.Signal=GPIO_Output
PE11.Signal=SPI4_NSS
PE12.Signal=SPI4_SCK
PE13.Signal=SPI4_MISO
PE14.Signal=SPI4_MOSI
PE5.GPIO_Label=FAN0_PWM
PE5.Signal=S_TIM9_CH1
PE6.GPIO_Label=FAN0_TACH
PE6.Signal=S_TIM9_CH2
PE7.GPIO_Label=nDP_EN
PE7.Signal=GPIO_Output
PE8.GPIO_Label=DN_EN
PE8.Signal=GPIO_Output
PE9.GPIO_Label=WS22_A
PE9.Signal=S_TIM1_CH1
PH0/OSC_IN.Signal=RCC_OSC_IN
PH1/OSC_OUT.Signal=RCC_OSC_OUT
