sscp/ws22-refresh/(commit log)

2025-01-11 First mechanical content
    Includes logic board hole pattern and Tritium-provided sheet-metal enclosure.
    [ws22-logic-pcba-release-fixture.3mf, ws22-logic-pcba-release-fixture.f3d, ws22-stock-enclosure.f3d]
2025-01-11 First commit for electronics
    [can_tcan1462v.SchDoc, conn_usbc.SchDoc, eth_100base-tx_magnetics.SchDoc, eth_lan8742a_phy.SchDoc, fan_interface.SchDoc, mcu_stm32f427.SchDoc, pmic_tps65263_buck.SchDoc, top.SchDoc]
2025-03-05 Making schematic progress
    [can_tcan1462v.SchDoc, conn_ffc_ws22_12pin.SchDoc, conn_ffc_ws22_8pin.SchDoc, conn_usbc.SchDoc, eth_100base-tx_magnetics.SchDoc, eth_lan8742a_phy.SchDoc, fan_interface.SchDoc, mcu_stm32f427.SchDoc]
2025-03-07 Continued schematic work
    [conn_lv.SchDoc, conn_motor.SchDoc, resolver_ad2s1200.SchDoc, top.SchDoc, ws22_companion-1_0_0.PrjPcb]
2025-03-09 Nearing schematic completion
    [can_tcan1462v.SchDoc, conn_ffc_ws22_12pin.SchDoc, conn_ffc_ws22_8pin.SchDoc, conn_lv.SchDoc, conn_motor.SchDoc, driver_am26c31_isolated.SchDoc, interface_hall.SchDoc, interface_ntc10k.SchDoc]
2025-03-09 STM32 pin assignments complete
    [can_tcan1462v.SchDoc, conn_ffc_ws22_12pin.SchDoc, conn_ffc_ws22_8pin.SchDoc, conn_lv.SchDoc, conn_motor.SchDoc, conn_usbc.SchDoc, driver_am26c31_isolated.SchDoc, eth_100base-tx_magnetics.SchDoc]
2025-03-09 First pass of schematic tidying complete
    [can_tcan1462v.SchDoc, conn_ffc_ws22_12pin.SchDoc, conn_ffc_ws22_8pin.SchDoc, conn_lv.SchDoc, conn_motor.SchDoc, conn_usbc.SchDoc, driver_am26c31_isolated.SchDoc, eth_100base-tx_magnetics.SchDoc]
2025-03-09 Aesthetic improvements
    [can_tcan1462v.SchDoc, conn_ffc_ws22_12pin.SchDoc, conn_ffc_ws22_8pin.SchDoc, conn_lv.SchDoc, conn_motor.SchDoc, conn_usbc.SchDoc, driver_am26c31_isolated.SchDoc, eth_100base-tx_magnetics.SchDoc]
2025-03-10 Fixed port-length corruption
    Also started doing some modest floor-planning.
    [can_tcan1462v.SchDoc, conn_ffc_ws22_12pin.SchDoc, conn_lv.SchDoc, conn_motor.SchDoc, driver_am26c31_isolated.SchDoc, eth_lan8742a_phy.SchDoc, fan_interface.SchDoc, interface_hall.SchDoc]
2025-03-10 Root caused and fixed weird port label resizing problem
    [can_tcan1462v.SchDoc, conn_ffc_ws22_12pin.SchDoc, conn_ffc_ws22_8pin.SchDoc, conn_lv.SchDoc, conn_motor.SchDoc, conn_usbc.SchDoc, driver_am26c31_isolated.SchDoc, eth_100base-tx_magnetics.SchDoc]
2025-03-24 Rough placement complete
    [conn_ffc_ws22_12pin.SchDoc, conn_ffc_ws22_8pin.SchDoc, conn_lv.SchDoc, conn_motor.SchDoc, interface_temperature.SchDoc, mcu_stm32f427.SchDoc, pmic_tps65263_buck.SchDoc, receiver_am26c32.SchDoc]
